Erschi520/STM32F103-Thermostat-FreeRTOS/FREETEM.ioc

Mcu.UserName=STM32F103C8Tx
PA1.Signal=GPIO_Input
PA10.Signal=S_TIM1_CH3
PA11.Signal=S_TIM1_CH4
PA13.Signal=SYS_JTMS-SWDIO
PA14.Signal=SYS_JTCK-SWCLK
PA2.Signal=GPXTI2
PA3.Signal=GPXTI3
PB8.Signal=I2C1_SCL
PB9.Signal=I2C1_SDA
PD0-OSC_IN.Signal=RCC_OSC_IN
PD1-OSC_OUT.Signal=RCC_OSC_OUT
